CamiloGilFranco/Trabajo-de-Grado-Ing.-Mec-nica/Programas Arduino/PLANO_DE_CONEXION_ARDUINO-TARJETA_DE_POTENCIA.png

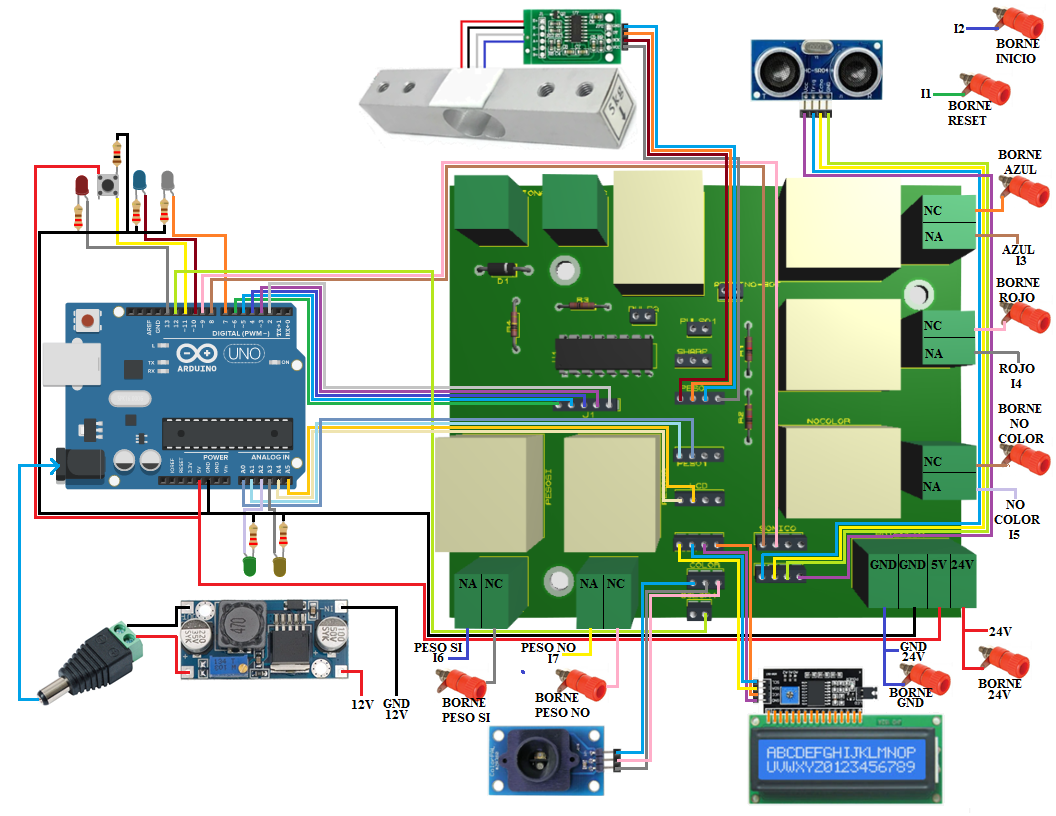
Programas Arduino/PLANO_DE_CONEXION_ARDUINO-TARJETA_DE_POTENCIA.png
