CamiloGilFranco/Trabajo-de-Grado-Ing.-Mec-nica/Planos/Barra Guia nueva.pdf

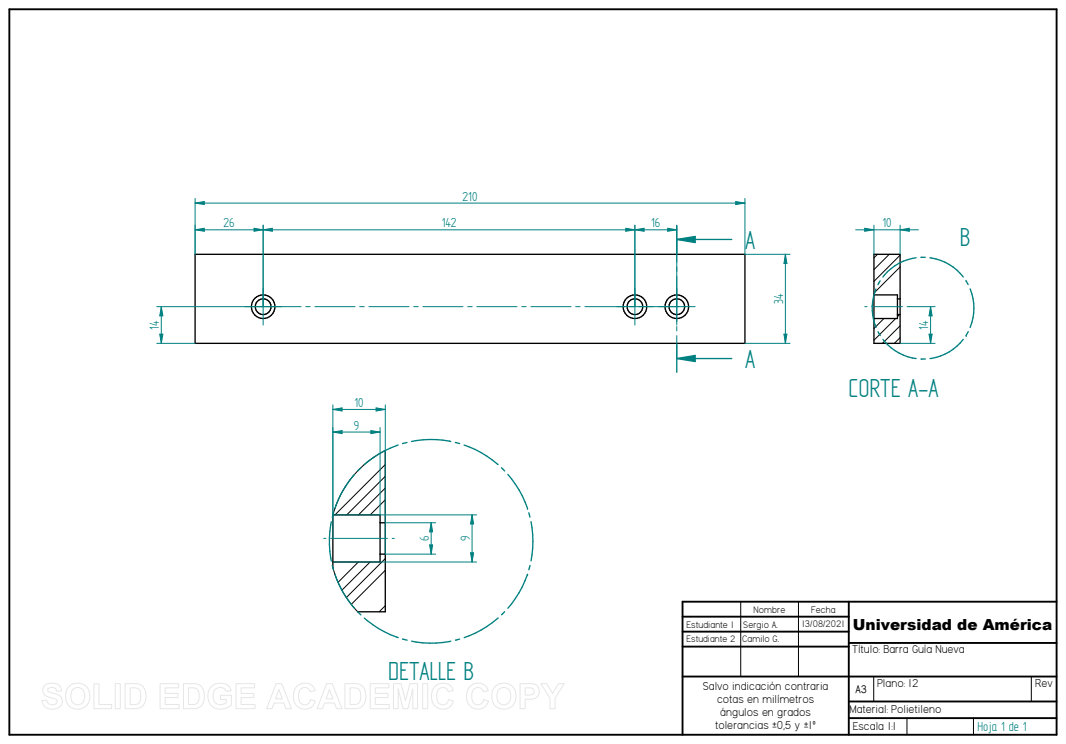
[picture p27: page 1]
Plano: 12; Rev; Escala 1:1; Material: Polietileno; Hoja 1 de 1; CORTE A-A; DETALLE B

Nombre | Fecha | Universidad de América

Estudiante 1 | Sergio A. | 13/08/2021
Estudiante 2 | Camilo G.

Título: Barra Guía Nueva

Salvo indicación contraria
cotas en milímetros
ángulos en grados
tolerancias ±0,5 y ±1º
