CamiloGilFranco/Trabajo-de-Grado-Ing.-Mec-nica/Planos/Garra 2.pdf

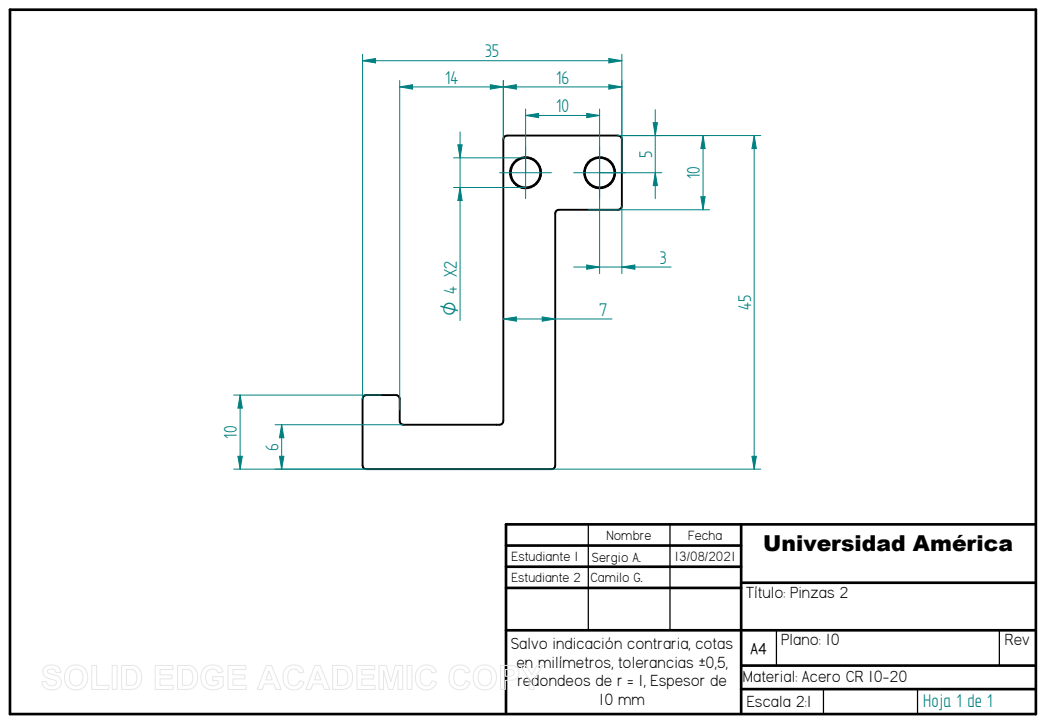
[picture p28: page 1]
Título: Pinzas 2; Plano: 10; Rev; Escala 2:1; Hoja 1 de 1

Nombre | Fecha | Universidad América

Estudiante 1 | Sergio A. | 13/08/2021
Estudiante 2 | Camilo G.

Salvo indicación contraria, cotas
en milímetros, tolerancias ±0,5,
redondeos de r = 1, Espesor de

Material: Acero CR 10-20
