CamiloGilFranco/Trabajo-de-Grado-Ing.-Mec-nica/Planos/platina Final de carrera.pdf

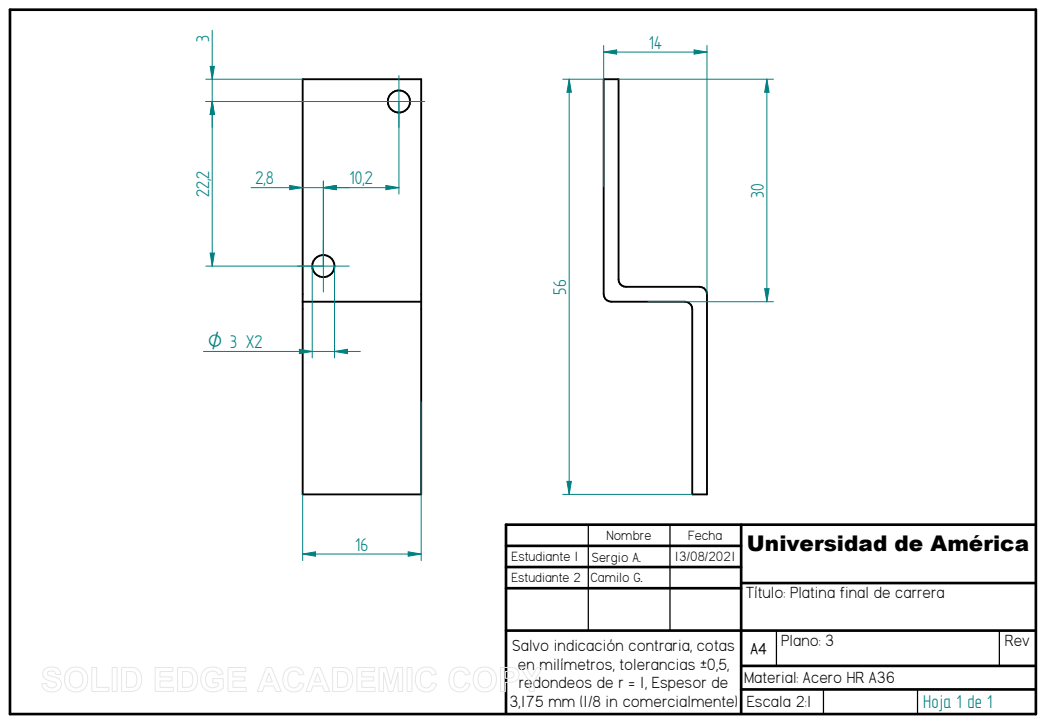
[picture p29: page 1]
Plano: 3; Rev; Escala 2:1; Hoja 1 de 1

Nombre | Fecha | Universidad de América

Estudiante 1 | Sergio A. | 13/08/2021
Estudiante 2 | Camilo G.

Título: Platina final de carrera

Salvo indicación contraria, cotas
en milímetros, tolerancias ±0,5,
redondeos de r = 1, Espesor de
3,175 mm (1/8 in comercialmente)

Material: Acero HR A36
