CamiloGilFranco/Trabajo-de-Grado-Ing.-Mec-nica/Planos/Varilla Guía P.pdf

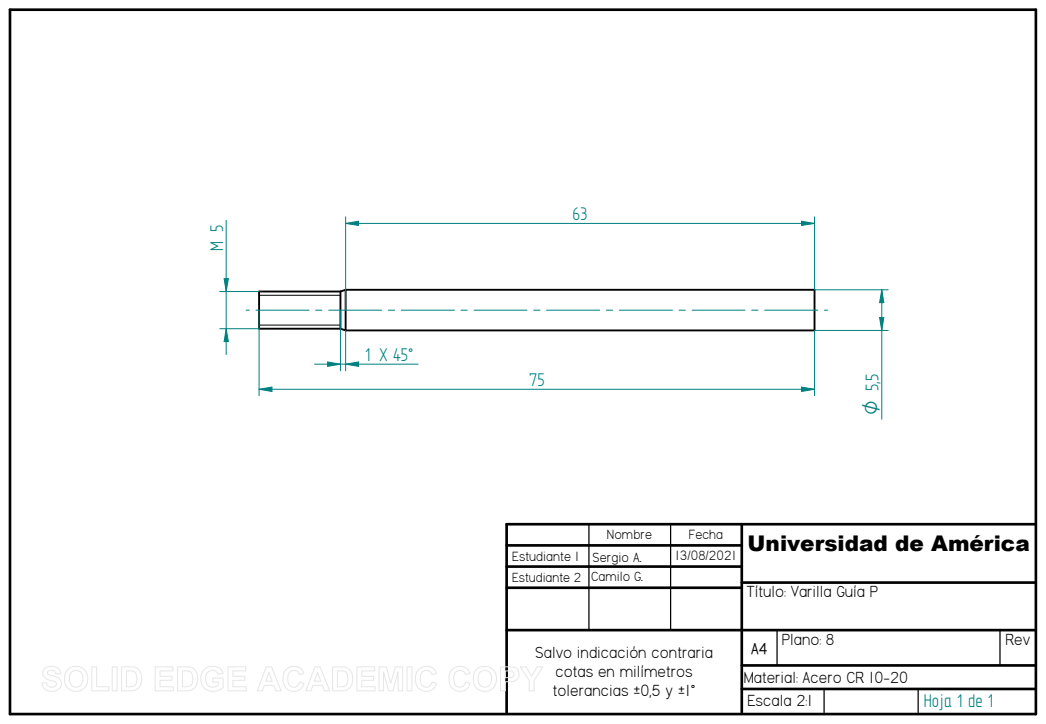
[picture p30: page 1]
Plano: 8; Rev; Escala 2:1; Hoja 1 de 1

Nombre | Fecha | Universidad de América

Estudiante 1 | Sergio A. | 13/08/2021
Estudiante 2 | Camilo G.

Título: Varilla Guía P

Salvo indicación contraria
cotas en milímetros
tolerancias ±0,5 y ±1°

Material: Acero CR 10-20
