CamiloGilFranco/Trabajo-de-Grado-Ing.-Mec-nica/Planos/Varillas guia K.pdf

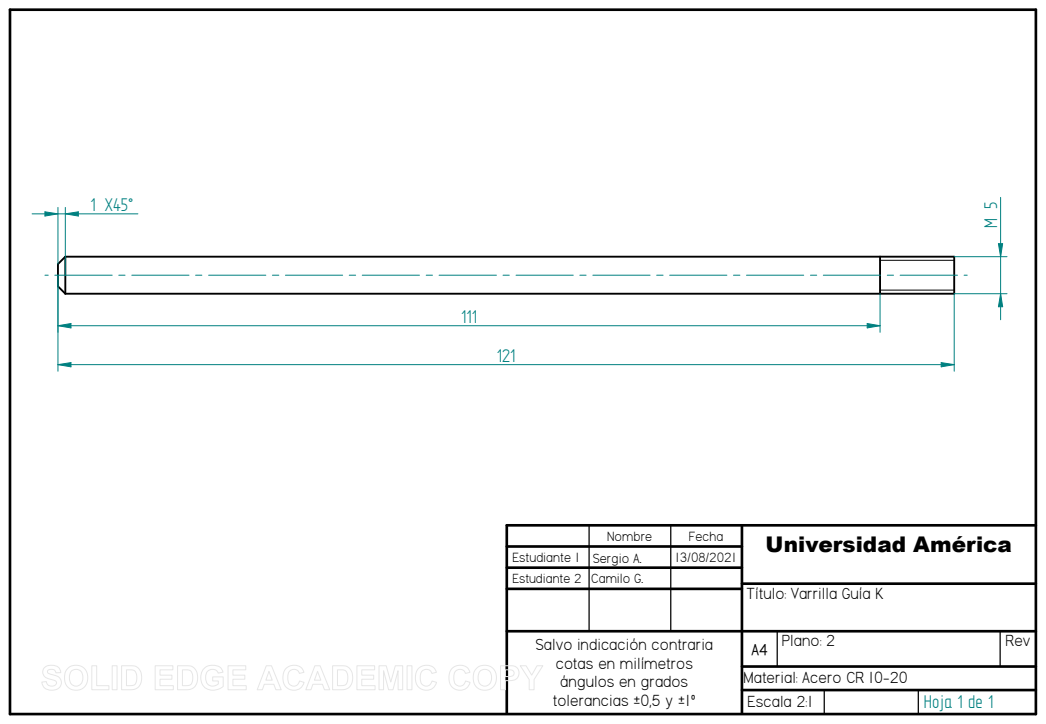
[picture p31: page 1]
Plano: 2; Rev; Escala 2:1; Hoja 1 de 1

Nombre | Fecha | Universidad América

Estudiante 1 | Sergio A. | 13/08/2021
Estudiante 2 | Camilo G.

Título: Varrilla Guía K

Salvo indicación contraria
cotas en milímetros
ángulos en grados
tolerancias ±0,5 y ±1º

Material: Acero CR 10-20
